kai0930/73-para-board/software/README.md

# ソフトウェア README

## 使用ソフト・物品等

| 名称 | バージョン | 備考 |
| --- | --- | --- |
| ESP-IDF | 5.4 | VSCodeプラグイン |
| ESP-S3 | | MCU |
| ICM-42688P | | 加速度センサ |
| LPS25HB | | 気圧センサ |
| 記憶モジュール | | microSDカード(SDMMC) |
