kai0930/73-para-board/(commit log)

2024-08-11 様々な修正
    [Avi_73J_ParaBoard_v2.kicad_sch, ParaBoard_Parts.csv]
2025-01-07 一時的にコミット
    [Avi_73J_ParaBoard_v2.kicad_sch, paraboard.csv]
2025-02-06 すべてのファイルを削除
    [Avi_73J_ParaBoard_v2-CuBottom.gbr, Avi_73J_ParaBoard_v2-CuTop.gbr, Avi_73J_ParaBoard_v2-EdgeCuts.gbr, Avi_73J_ParaBoard_v2-MaskBottom.gbr, Avi_73J_ParaBoard_v2-MaskTop.gbr, Avi_73J_ParaBoard_v2-NPTH.drl, Avi_73J_ParaBoard_v2-PTH.drl, Avi_73J_ParaBoard_v2-PasteBottom.gbr]
2025-02-06 Readmeを作成
2025-02-06 KiCadプロジェクトを追加
    [開放基板.kicad_pcb, 開放基板.kicad_sch]
2025-02-07 ESP-IDテストプロジェクトを作成
2025-02-07 LPS25HB、ICM20602のライブラリを作成
2025-02-07 動作試験用のコードを一部作成
2025-02-07 ドキュメントを追加
2025-02-07 サーボのライブラリを作成
2025-02-08 動作試験コードを作成
2025-02-14 新基板向けの修正
2025-02-14 不要なファイルを削除
2025-02-20 テストコードを作成
2025-02-22 いくつかの修正
2025-03-07 WSL用に修正
2025-03-07 メインファイルをcppに変更
2025-03-13 開放基板のコードを作成
2025-03-17 機能を追加
